lazerj7/MusicalDoorbell/Docs/PCB_3D_Back.png

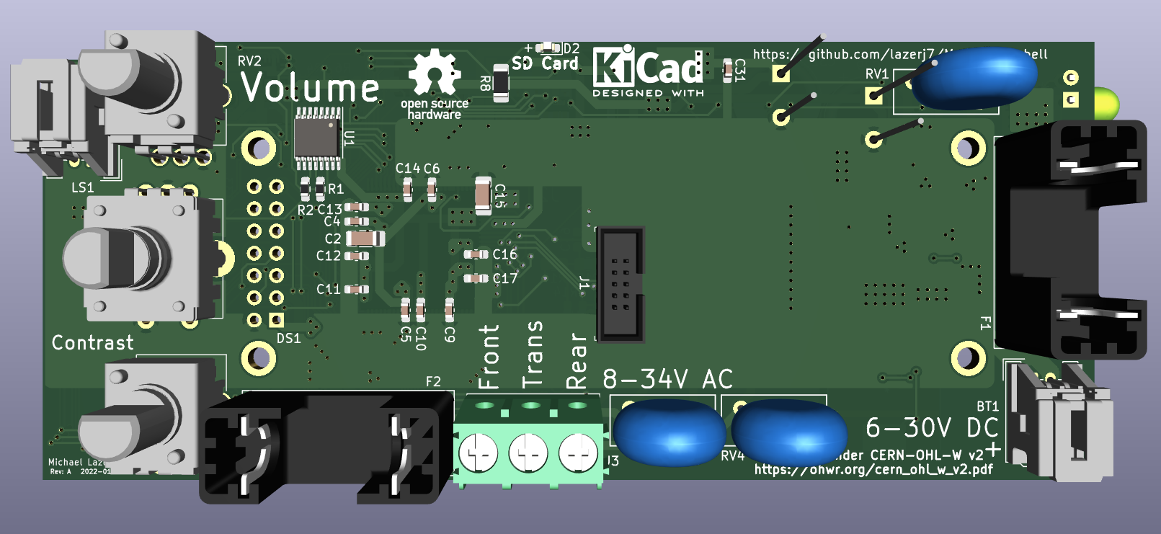
Docs/PCB_3D_Back.png
