lazerj7/MusicalDoorbell/Docs/PCB_3D_Front.png

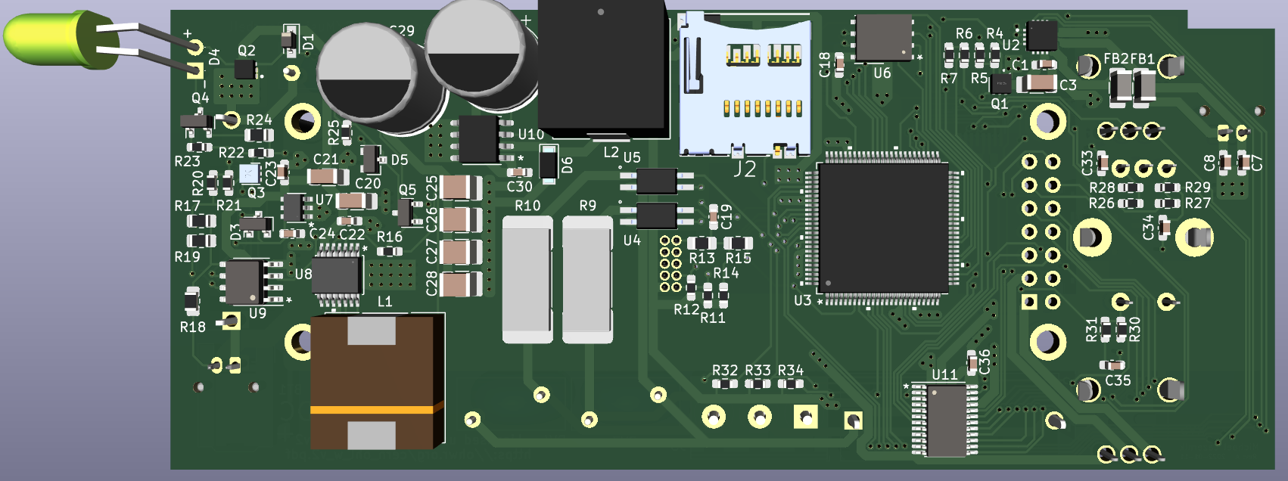
Docs/PCB_3D_Front.png
