lazerj7/MusicalDoorbell/Docs/Schematic.pdf

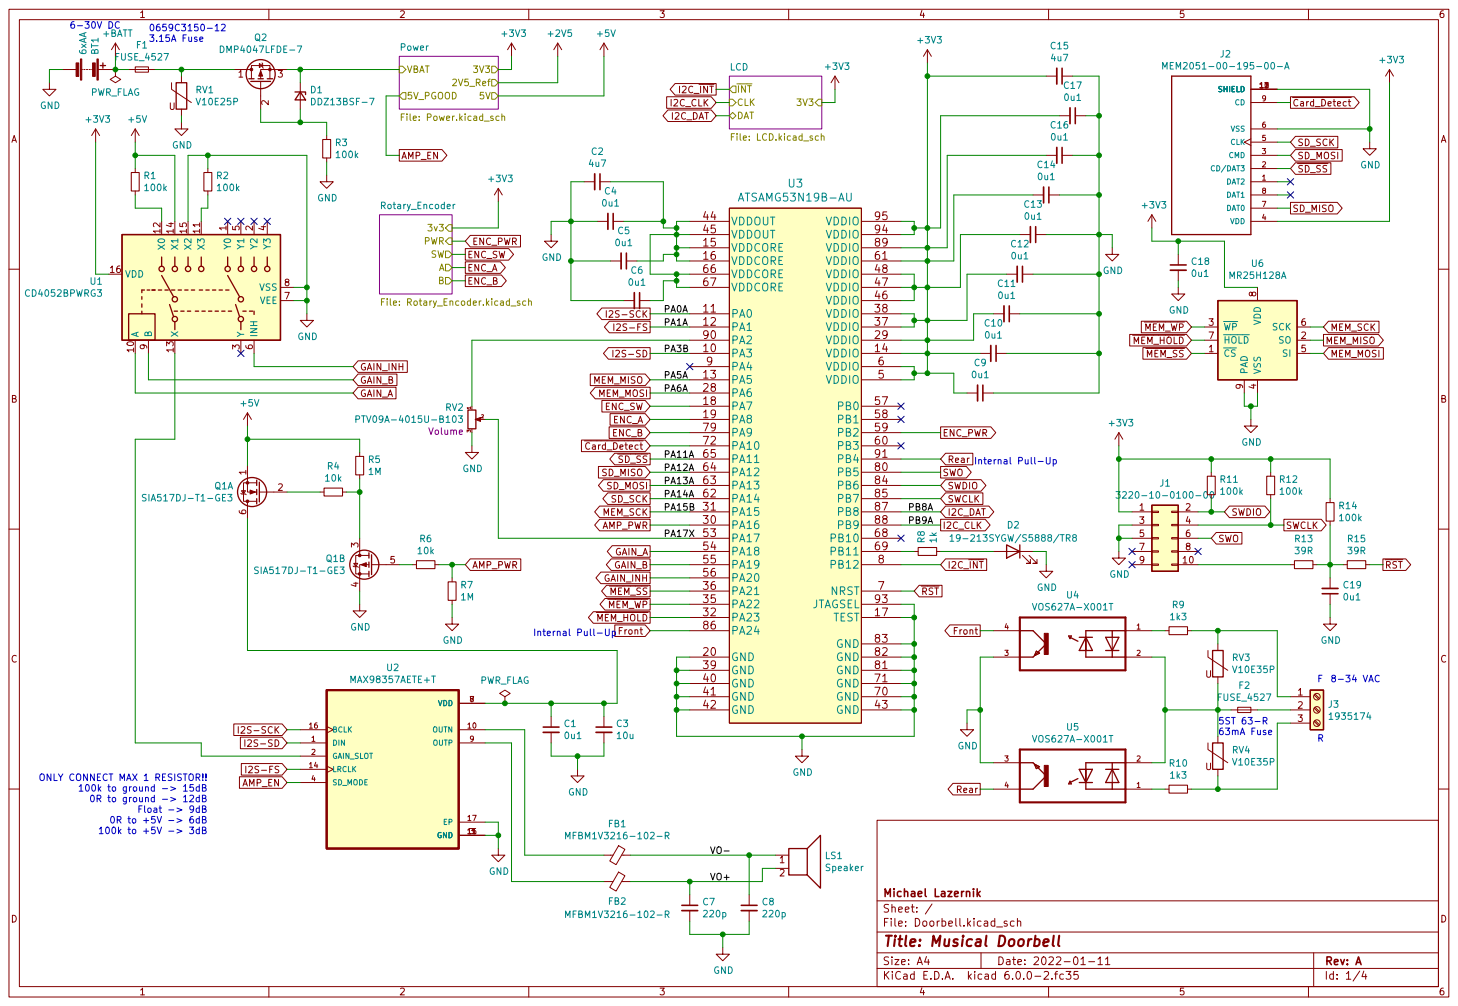
[picture p3: page 1]

4 SI 5 SCK 6 ~{HOLD} 7 VDD

63mA Fuse ONLY CONNECT MAX 1 RESISTOR!! 100k to ground -> 15dB

File: Doorbell.kicad_sch Sheet: / Michael Lazernik

Id: 1/4 Title: Musical Doorbell

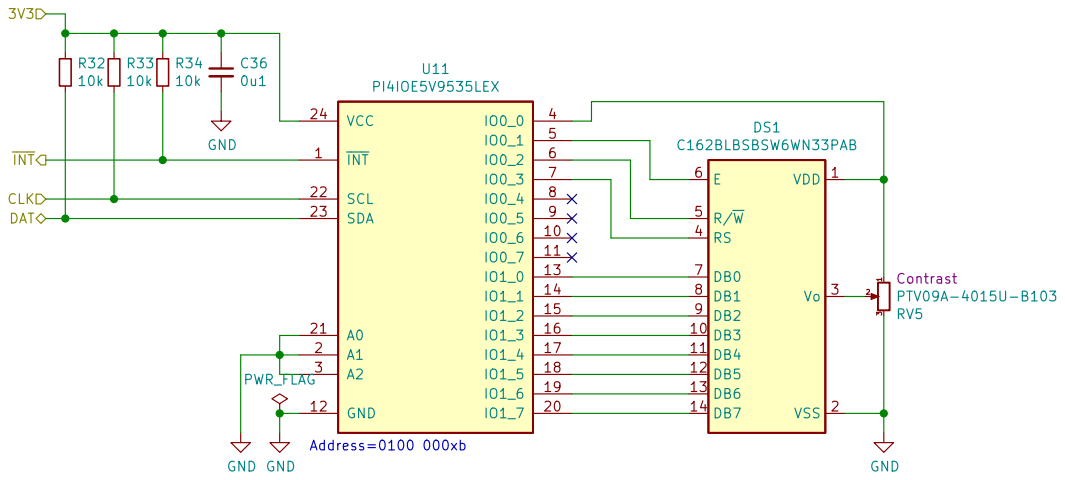
[picture p4: page 2]

3RV5PTV09A-4015U-B103 Contrast VDD 1 DB3 10 DB4 11 DB5 12 DB6 13 DB7 14 VSS 2 Vo 3 RS 4 R/~{W} 5 E

File: LCD.kicad_sch Sheet: /LCD/ Michael Lazernik

Id: 2/4 Title: Musical Doorbell

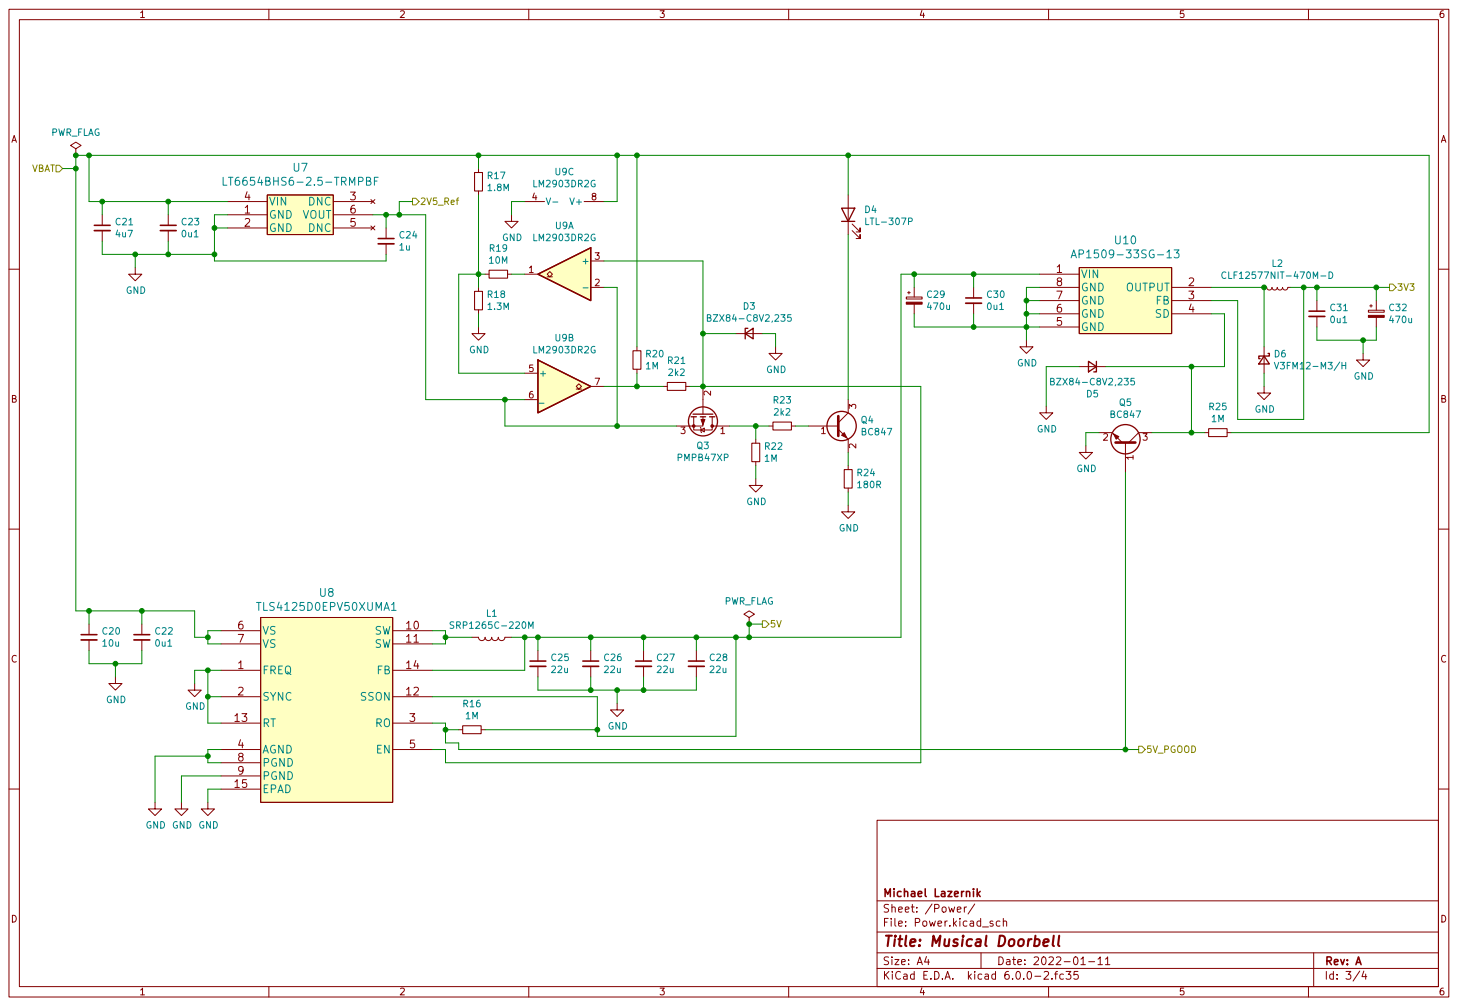
[picture p5: page 3]

GND GND

File: Power.kicad_sch Sheet: /Power/ Michael Lazernik

Id: 3/4 Title: Musical Doorbell

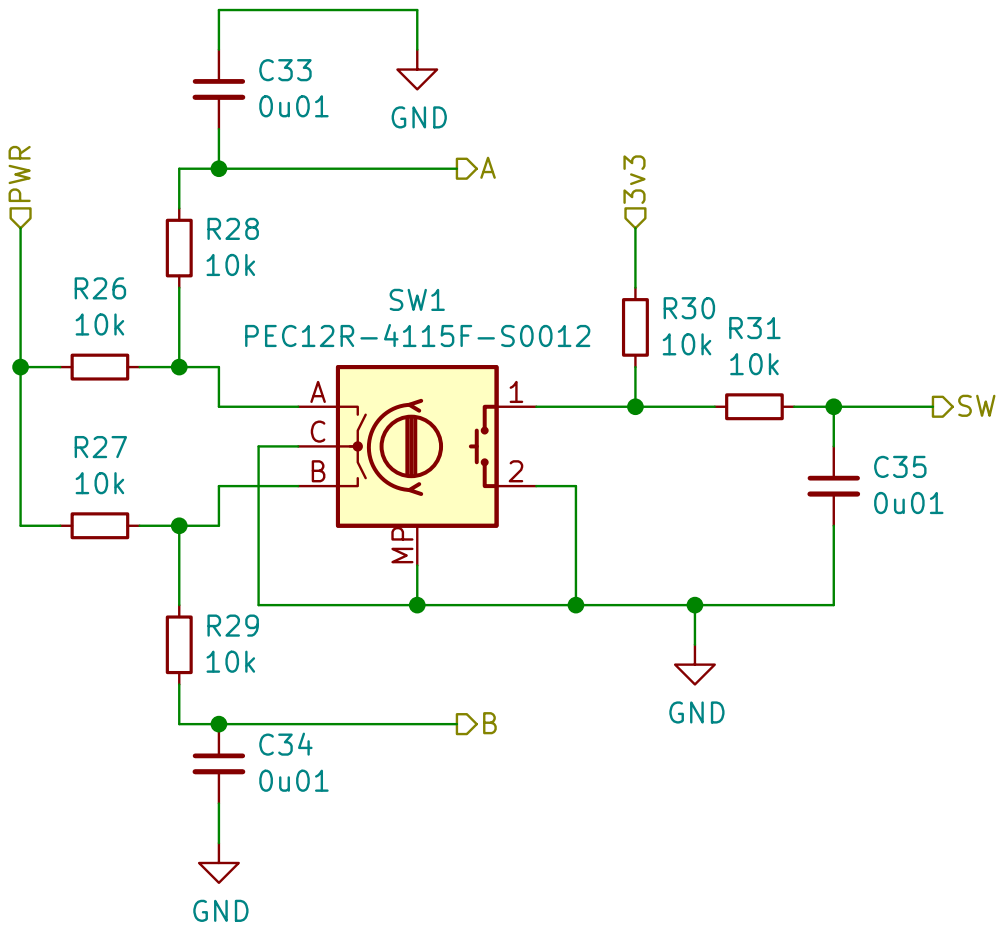
[picture p6: page 4]

File: Rotary_Encoder.kicad_sch
Id: 4/4 Title: Musical Doorbell
