lazerj7/MusicalDoorbell/Docs/PCB.pdf

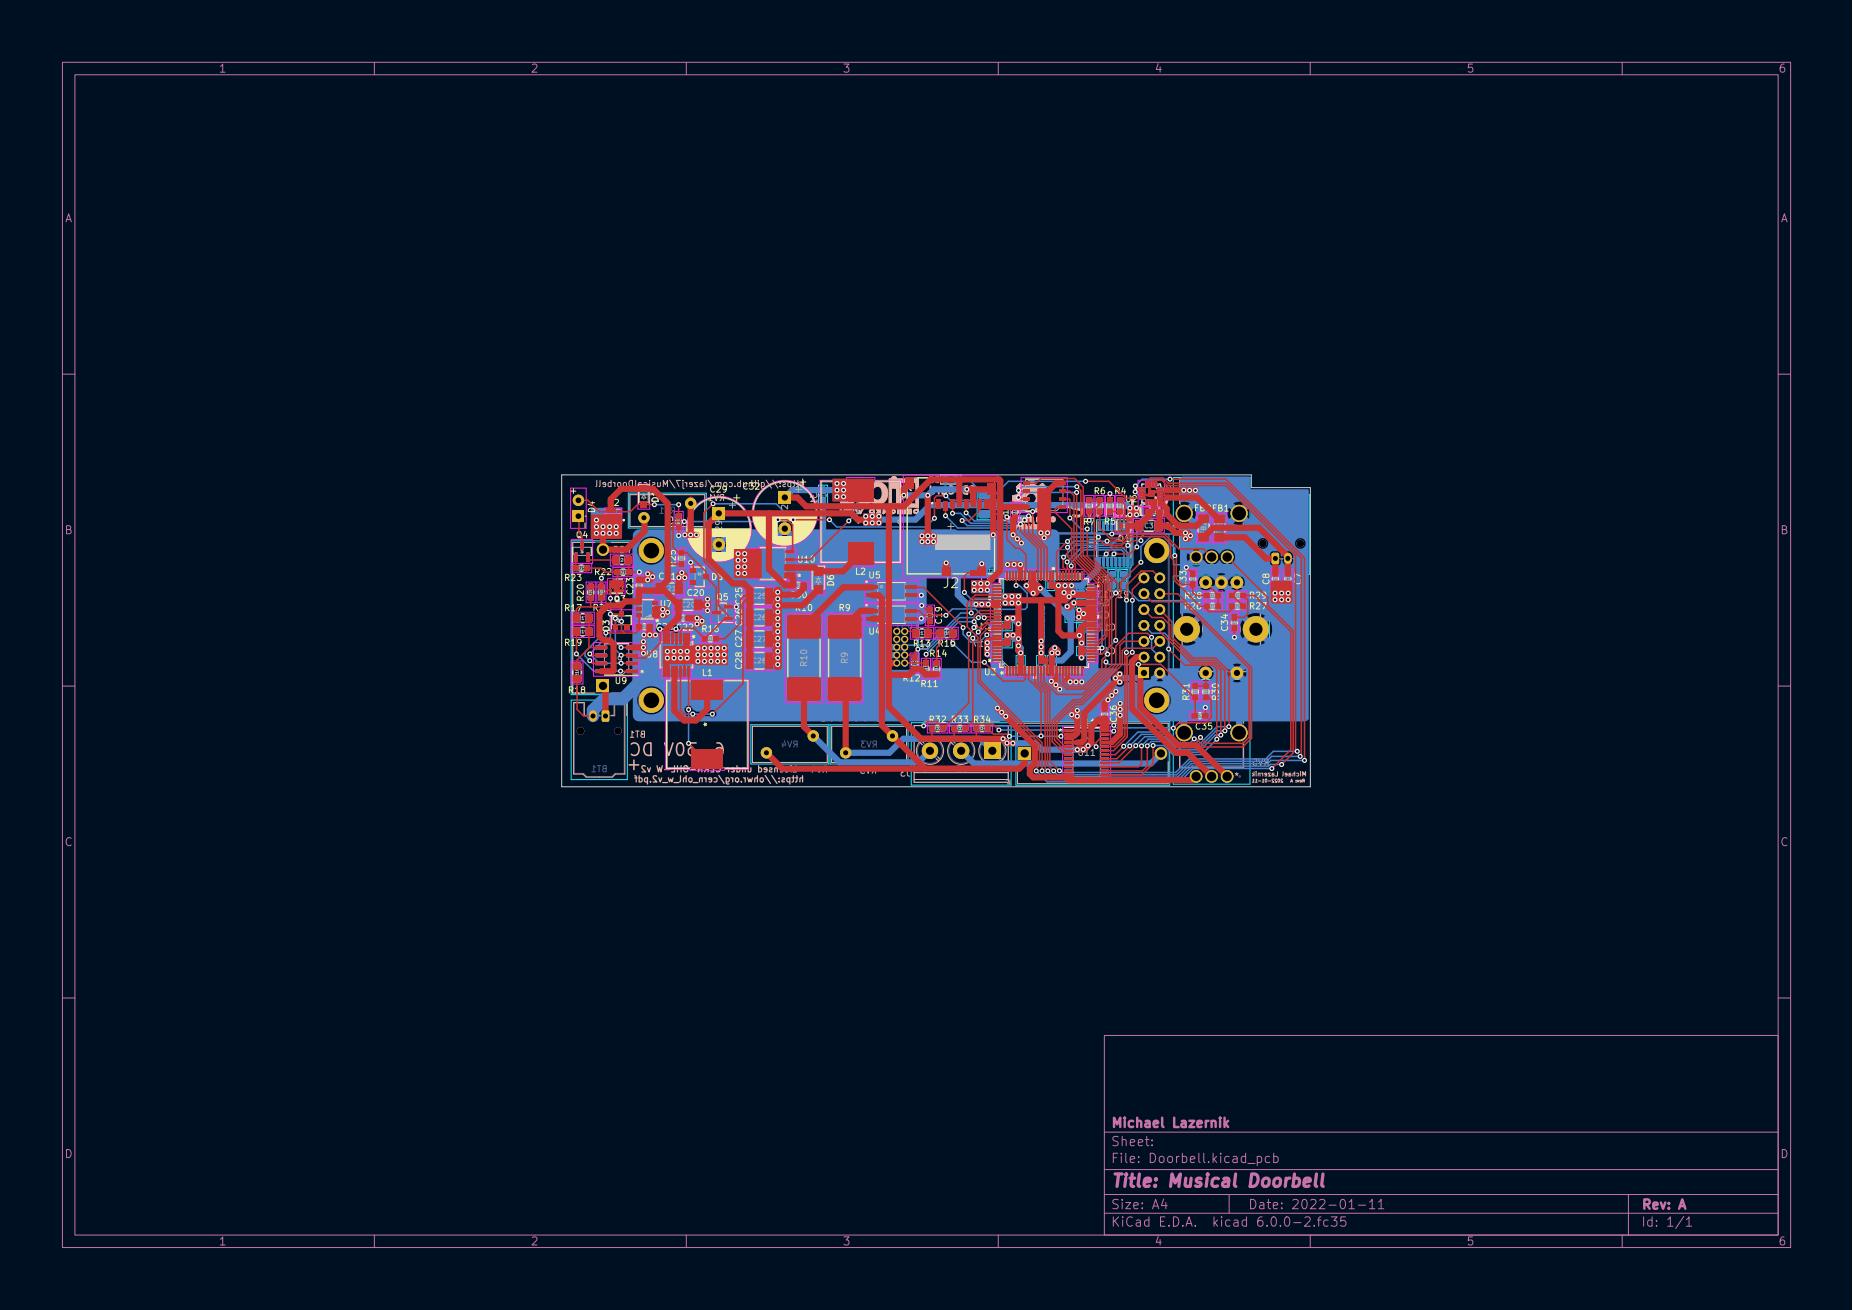
[picture p7: page 1]
