lazerj7/MusicalDoorbell/Docs/PCB_Back.pdf

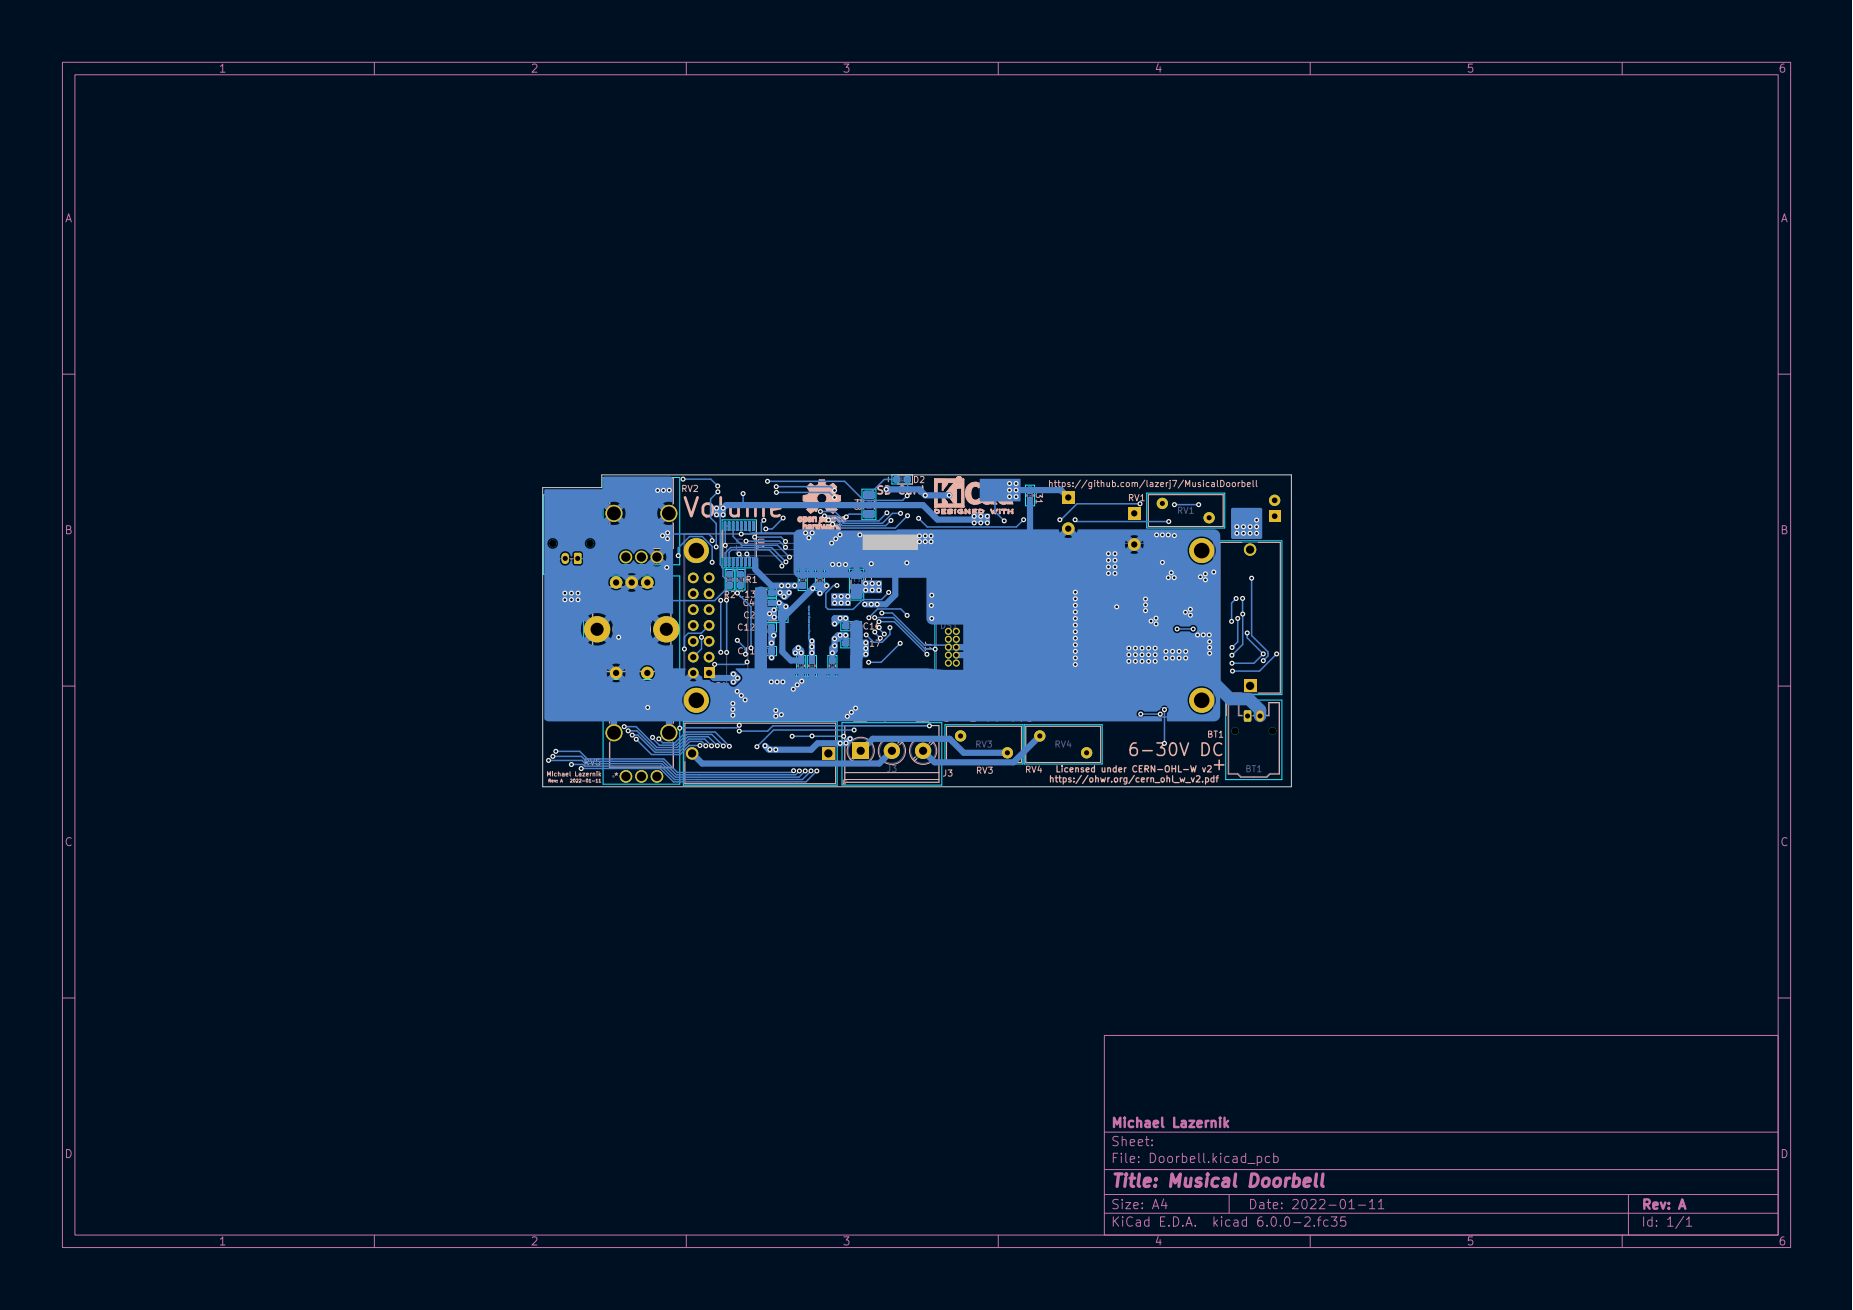
[picture p8: page 1]
