lazerj7/MusicalDoorbell/Docs/PCB_Front.pdf

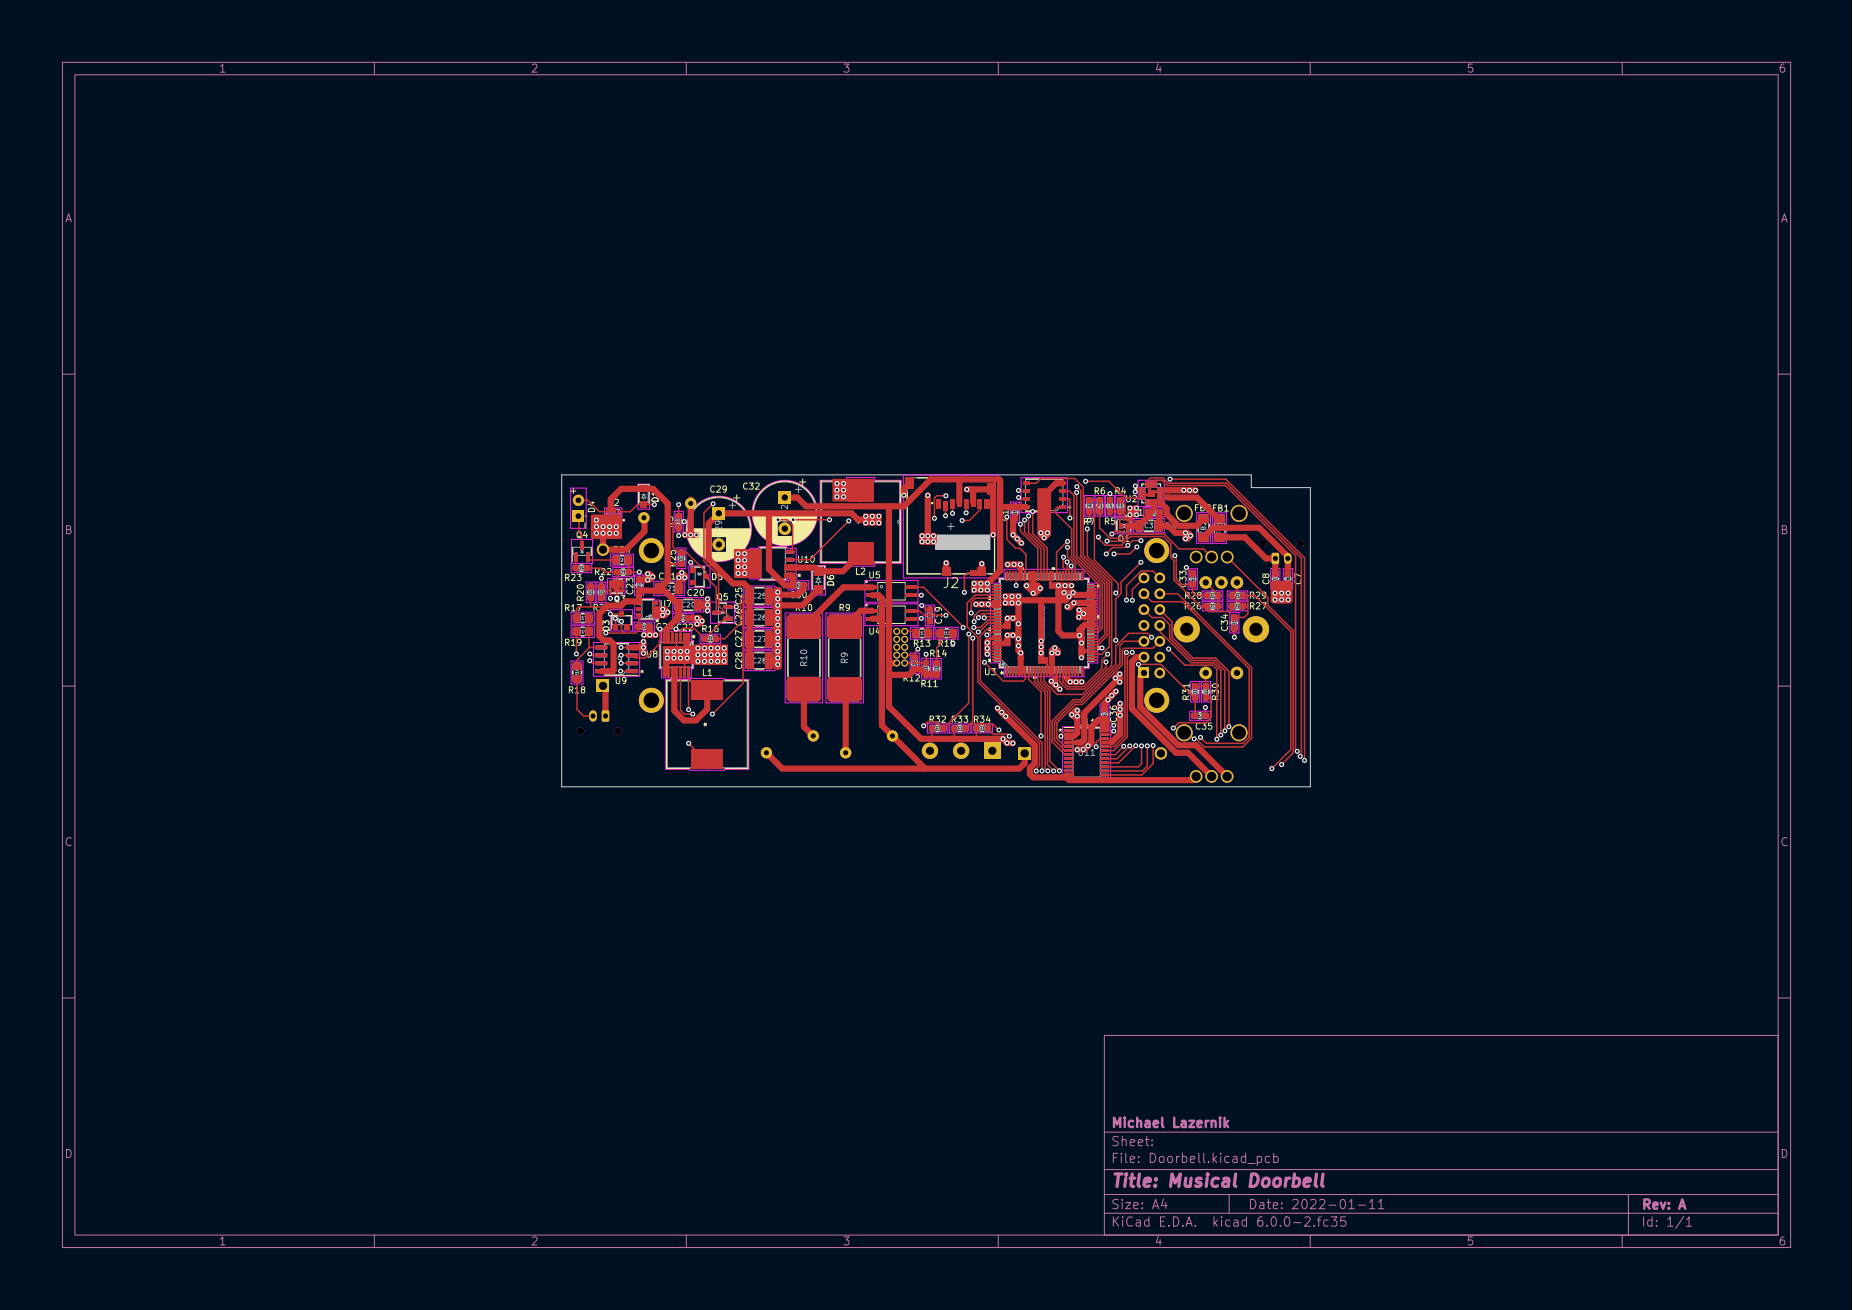
[picture p9: page 1]
