lazerj7/MusicalDoorbell/Hardware/Doorbell.kicad_pcb

## KiCad design Hardware/Doorbell.kicad_pcb (2022-02-26)

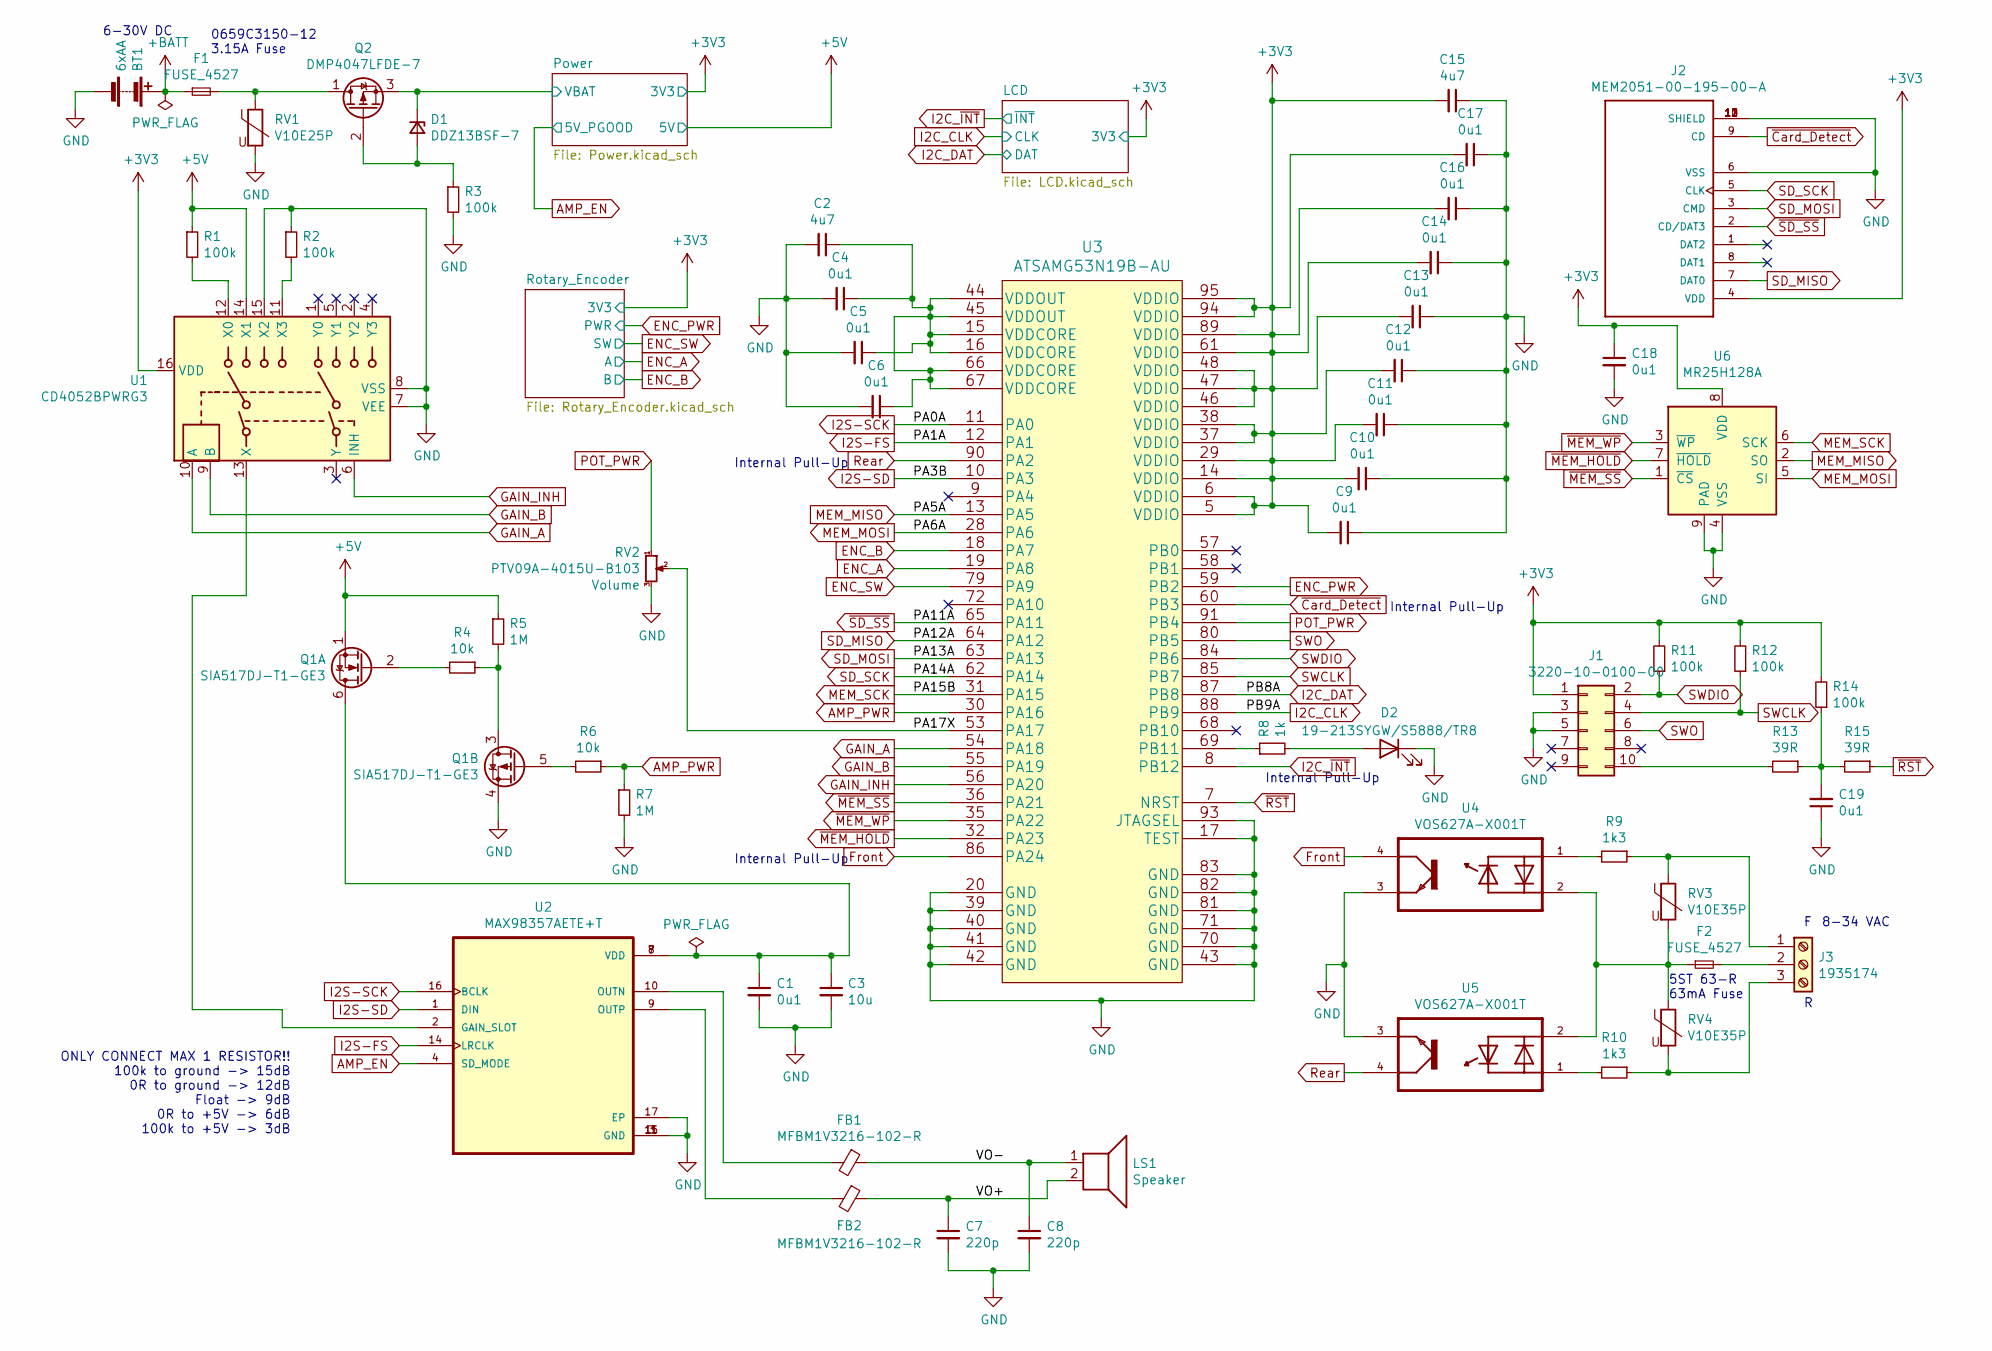
[picture p10: schematic Doorbell.kicad_sch, Musical Doorbell]

Parts:
BT1: 6xAA; Molex_MicroClasp_55935-0210_1x02_P2.00mm_Horizontal
C1, C4, C5, C6, C9, C10, C11, C12, C13, C14, C16, C17, C18, C19: 0u1; C_0603_1608Metric_Pad1.08x0.95mm_HandSolder
C2, C15: 4u7; C_1206_3216Metric_Pad1.33x1.80mm_HandSolder
C3: 10u; C_1206_3216Metric_Pad1.33x1.80mm_HandSolder
C7, C8: 220p; C_0603_1608Metric_Pad1.08x0.95mm_HandSolder
D1: DDZ13BSF-7; D_SOD-323_HandSoldering
D2: 19-213SYGW/S5888/TR8; LED_0603_1608Metric_Pad1.05x0.95mm_HandSolder
F1, F2: FUSE_4527
FB1, FB2: MFBM1V3216-102-R; L_1206_3216Metric_Pad1.42x1.75mm_HandSolder
J1: 3220-10-0100-00
J2: MEM2051-00-195-00-A
J3: 1935174; TerminalBlock_Phoenix_PT-1,5-3-5.0-H_1x03_P5.00mm_Horizontal
LS1: Speaker; Molex_MicroClasp_55935-0210_1x02_P2.00mm_Horizontal
Q1: SIA517DJ-T1-GE3; Vishay_PowerPAK_SC70-6L_Dual
Q2: DMP4047LFDE-7
R1, R2, R3, R11, R12, R14: 100k; R_0603_1608Metric_Pad0.98x0.95mm_HandSolder
R4, R6: 10k; R_0603_1608Metric_Pad0.98x0.95mm_HandSolder
R5, R7: 1M; R_0603_1608Metric_Pad0.98x0.95mm_HandSolder
R8: 1k; R_1206_3216Metric_Pad1.30x1.75mm_HandSolder
R9, R10: 1k3; 35501K3FT
R13, R15: 39R; R_0805_2012Metric_Pad1.20x1.40mm_HandSolder
RV1: V10E25P; RV_Disc_D12mm_W5.1mm_P7.5mm
RV2: PTV09A-4015U-B103
RV3, RV4: V10E35P; RV_Disc_D12mm_W5.8mm_P7.5mm
U1: CD4052BPWRG3; TSSOP-16_4.4x5mm_P0.65mm
U2: MAX98357AETE+T; MAX98357AETE_T
U3: ATSAMG53N19B-AU
U4, U5: VOS627A-X001T
U6: MR25H128A; DFN-8-1EP_6x5mm_P1.27mm_EP2x2mm

Connections:
+3V3: C9.2, C10.2, C11.2, C12.2, C13.2, C14.2, C15.2, C16.2, C17.2, C18.1, J1.1, J2.4 (VDD), R11.2, R12.2, R14.2, U1.16 (VDD), U3.5 (VDDIO), U3.6 (VDDIO), U3.14 (VDDIO), U3.29 (VDDIO), U3.37 (VDDIO), U3.38 (VDDIO), U3.46 (VDDIO), U3.47 (VDDIO), U3.48 (VDDIO), U3.61 (VDDIO), U3.89 (VDDIO), U3.94 (VDDIO), U3.95 (VDDIO), U6.8 (VDD); also elsewhere on the board
+5V: Q1.1 (S2), R1.1, R5.1, U1.14 (X1); also elsewhere on the board
+BATT: BT1.1 (+), F1.1
/PA17X: RV2.2, U3.53 (PA17)
/Power/VBAT: D1.1 (K), Q2.3 (S); also elsewhere on the board
/VO+: C7.1, FB2.1, LS1.2
/VO-: C8.1, FB1.1, LS1.1
AMP_EN: U2.4 (SD_MODE); also elsewhere on the board
AMP_PWR: R6.1, R7.1, U3.30 (PA16)
ENC_A: U3.19 (PA8); also elsewhere on the board
ENC_B: U3.18 (PA7); also elsewhere on the board
ENC_PWR: U3.59 (PB2); also elsewhere on the board
ENC_SW: U3.79 (PA9); also elsewhere on the board
Front: U3.86 (PA24), U4.4
GAIN_A: U1.10 (A), U3.54 (PA18)
GAIN_B: U1.9 (B), U3.55 (PA19)
GAIN_INH: U1.6 (INH), U3.56 (PA20)
GND: BT1.2 (-), C1.2, C2.2, C3.2, C4.2, C5.2, C6.2, C7.2, C8.2, C9.1, C10.1, C11.1, C12.1, C13.1, C14.1, C15.1, C16.1, C17.1, C18.2, C19.1, D2.1 (K), J1.3, J1.5, J2.6 (VSS), J2.10 (SHIELD), J2.11 (SHIELD), J2.12 (SHIELD), J2.13 (SHIELD), Q1.4 (S2), R2.1, R3.2, R7.2, RV1.2, RV2.3, RV2.4, RV2.5, U1.7 (VEE), U1.8 (VSS), U1.15 (X2), U2.3 (GND), U2.11 (GND), U2.15 (GND), U2.17 (EP), U3.17 (TEST), U3.20 (GND), U3.39 (GND), U3.40 (GND), U3.41 (GND), U3.42 (GND), U3.43 (GND), U3.70 (GND), U3.71 (GND), U3.81 (GND), U3.82 (GND), U3.83 (GND), U3.93 (JTAGSEL), U4.3, U5.3, U6.4 (VSS), U6.9 (PAD); also elsewhere on the board
I2C_CLK: U3.88 (PB9); also elsewhere on the board
I2C_DAT: U3.87 (PB8); also elsewhere on the board
I2C_~INT: U3.8 (PB12); also elsewhere on the board
I2S-FS: U2.14 (LRCLK), U3.12 (PA1)
I2S-SCK: U2.16 (BCLK), U3.11 (PA0)
I2S-SD: U2.1 (DIN), U3.10 (PA3)
MEM_MISO: U3.13 (PA5), U6.2 (SO)
MEM_MOSI: U3.28 (PA6), U6.5 (SI)
MEM_SCK: U3.31 (PA15), U6.6 (SCK)
unnamed: C1.1, C3.1, Q1.6 (D2), U2.7 (VDD), U2.8 (VDD)
unnamed: C2.1, C4.1, C5.1, C6.1, U3.15 (VDDCORE), U3.16 (VDDCORE), U3.44 (VDDOUT), U3.45 (VDDOUT), U3.66 (VDDCORE), U3.67 (VDDCORE)
unnamed: C19.2, R13.1, R14.1, R15.2
unnamed: D1.2 (A), Q2.2 (G), R3.1
unnamed: D2.2 (A), R8.2
unnamed: F1.2, Q2.1 (D), RV1.1
unnamed: F2.1, RV3.2, RV4.1, U4.2, U5.2
unnamed: F2.2, J3.2
unnamed: FB1.2, U2.10 (OUTN)
unnamed: FB2.2, U2.9 (OUTP)
unnamed: J1.10, R13.2
unnamed: J3.1, R9.1, RV3.1
unnamed: J3.3, R10.1, RV4.2
unnamed: Q1.2 (G2), R4.2
unnamed: Q1.3 (D2), R4.1, R5.2
unnamed: Q1.5 (G2), R6.2
unnamed: R1.2, U1.12 (X0)
unnamed: R2.2, U1.11 (X3)
unnamed: R8.1, U3.69 (PB11)
unnamed: R9.2, U4.1
unnamed: R10.2, U5.1
unnamed: U1.13 (X), U2.2 (GAIN_SLOT)
POT_PWR: RV2.1, U3.91 (PB4)
Rear: U3.90 (PA2), U5.4
SD_MISO: J2.7 (DAT0), U3.64 (PA12)
SD_MOSI: J2.3 (CMD), U3.63 (PA13)
SD_SCK: J2.5 (CLK), U3.62 (PA14)
SWCLK: J1.4, R12.1, U3.85 (PB7)
SWDIO: J1.2, R11.1, U3.84 (PB6)
SWO: J1.6, U3.80 (PB5)
~Card_Detect: J2.9 (CD), U3.60 (PB3)
~MEM_HOLD: U3.32 (PA23), U6.7 (~HOLD)
~MEM_SS: U3.36 (PA21), U6.1 (~CS)
~MEM_WP: U3.35 (PA22), U6.3 (~WP)
~RST: R15.1, U3.7 (NRST)
~SD_SS: J2.2 (CD/DAT3), U3.65 (PA11)

Notes on the sheet:
Internal Pull-Up
6-30V DC
8-34 VAC
0659C3150-12 3.15A Fuse
ONLY CONNECT MAX 1 RESISTOR!! 100k to ground -> 15dB 0R to ground -> 12dB Float -> 9dB 0R to +5V -> 6dB 100k to +5V -> 3dB
5ST 63-R 63mA Fuse

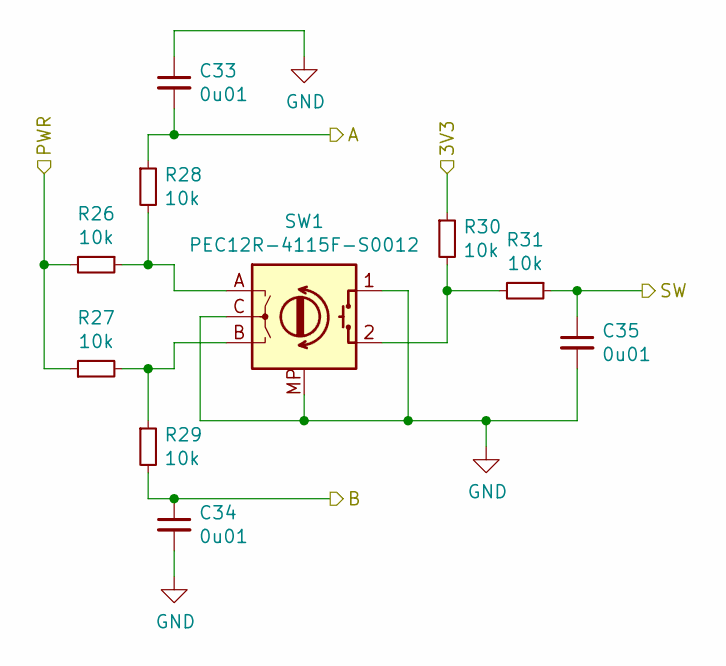
[picture p11: schematic Rotary_Encoder.kicad_sch, Musical Doorbell]

Parts:
C33, C34, C35: 0u01; C_0603_1608Metric_Pad1.08x0.95mm_HandSolder
R26, R27, R28, R29, R30, R31: 10k; R_0603_1608Metric_Pad0.98x0.95mm_HandSolder
SW1: PEC12R-4115F-S0012

Connections:
+3V3: R30.1; also elsewhere on the board
ENC_A: C33.2, R28.1; also elsewhere on the board
ENC_B: C34.1, R29.2; also elsewhere on the board
ENC_PWR: R26.2, R27.1; also elsewhere on the board
ENC_SW: C35.1, R31.1; also elsewhere on the board
GND: C33.1, C34.2, C35.2, SW1.1, SW1.C, SW1.MP; also elsewhere on the board
unnamed: R26.1, R28.2, SW1.A
unnamed: R27.2, R29.1, SW1.B
unnamed: R30.2, R31.2, SW1.2

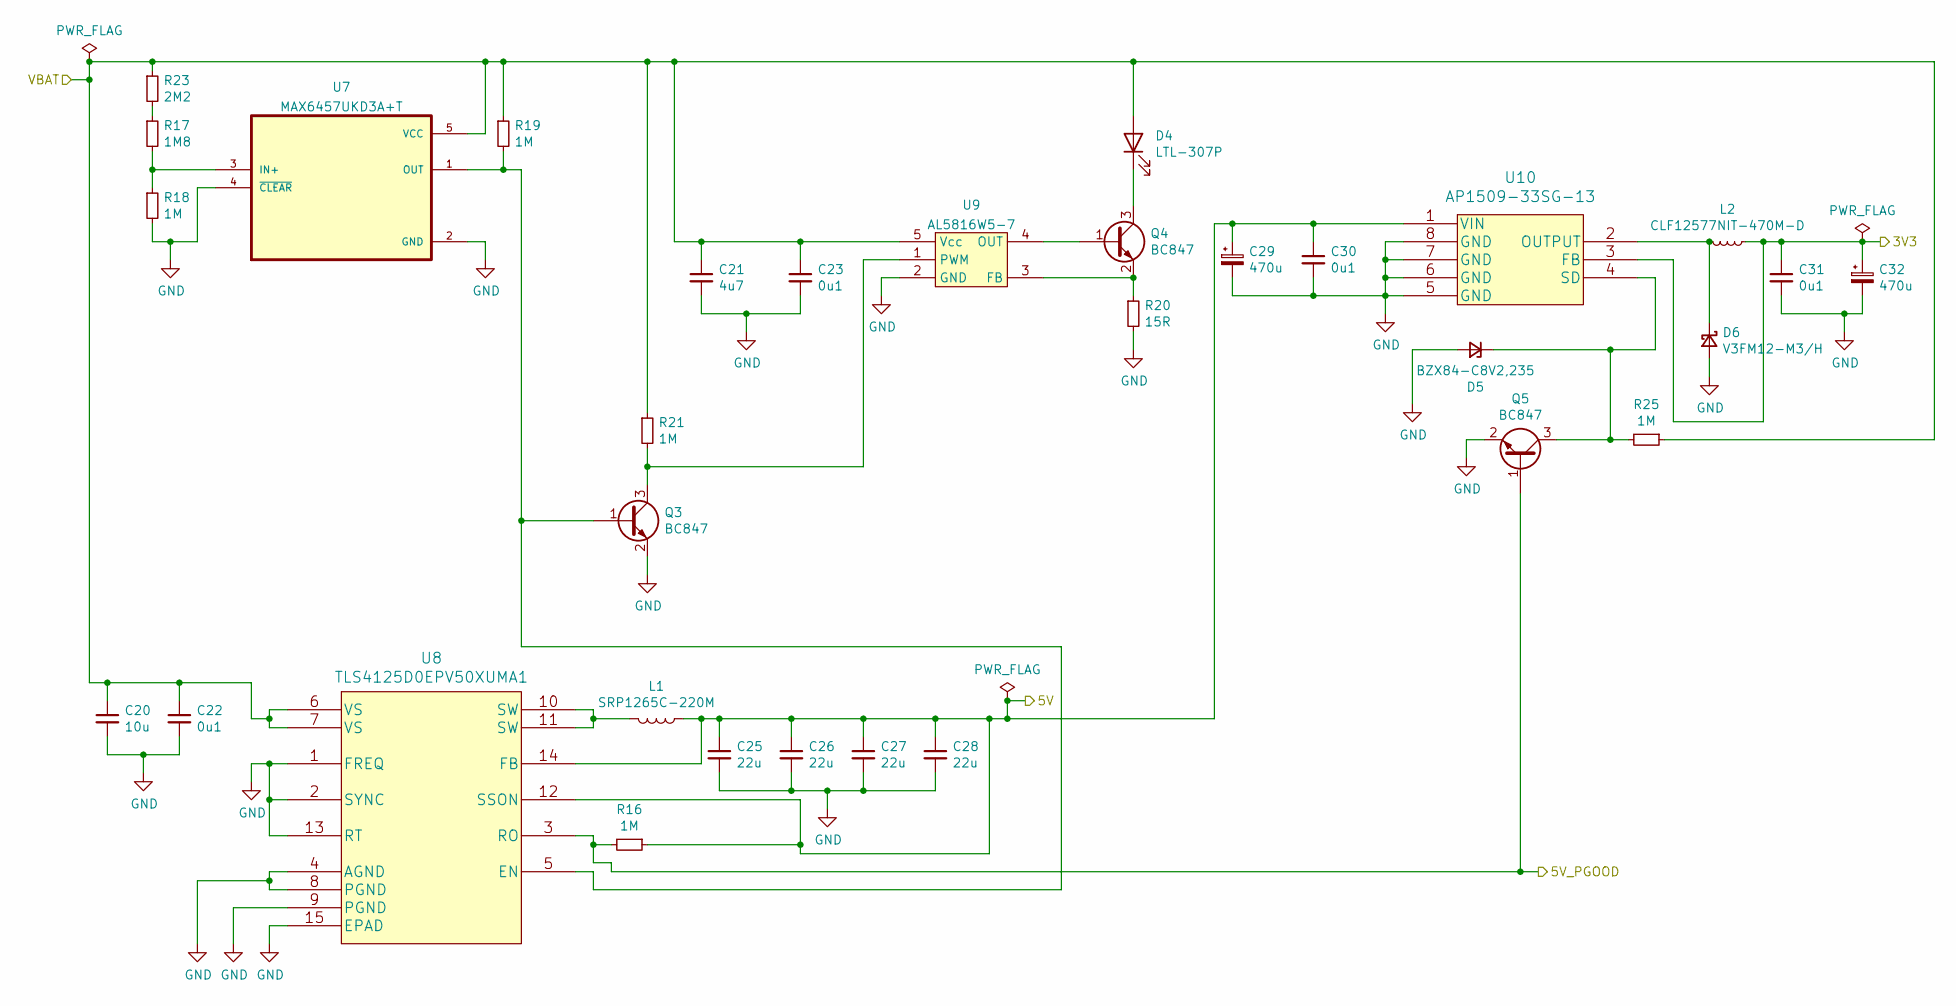
[picture p12: schematic Power.kicad_sch, Musical Doorbell]

Parts:
C20: 10u; C_1206_3216Metric_Pad1.33x1.80mm_HandSolder
C21: 4u7; C_1206_3216Metric_Pad1.33x1.80mm_HandSolder
C22, C23, C30, C31: 0u1; C_0603_1608Metric_Pad1.08x0.95mm_HandSolder
C25, C26, C27, C28: 22u; C_1210_3225Metric_Pad1.33x2.70mm_HandSolder
C29, C32: 470u; EEH-AZK1E471B
D4: LTL-307P
D5: BZX84-C8V2,235; D_SOT-23_ANK
D6: V3FM12-M3/H; V3FM12-M3_H
L1: SRP1265C-220M
L2: CLF12577NIT-470M-D
Q3, Q4, Q5: BC847; SOT-23
R16, R18, R19, R21, R25: 1M; R_0603_1608Metric_Pad0.98x0.95mm_HandSolder
R17: 1M8; R_0805_2012Metric_Pad1.20x1.40mm_HandSolder
R20: 15R; R_0805_2012Metric_Pad1.20x1.40mm_HandSolder
R23: 2M2; R_0603_1608Metric_Pad0.98x0.95mm_HandSolder
U7: MAX6457UKD3A+T
U8: TLS4125D0EPV50XUMA1
U9: AL5816W5-7
U10: AP1509-33SG-13

Connections:
+3V3: C31.1, C32.1, L2.1, U10.3 (FB); also elsewhere on the board
+5V: C25.1, C26.1, C27.1, C28.1, C29.1, C30.1, L1.1, R16.1, U8.12 (SSON), U8.14 (FB), U10.1 (VIN); also elsewhere on the board
/Power/VBAT: C20.1, C21.1, C22.1, C23.1, D4.2 (A), R19.1, R21.1, R23.1, R25.1, U7.5 (VCC), U8.6 (VS), U8.7 (VS), U9.5 (Vcc); also elsewhere on the board
AMP_EN: Q5.1 (B), R16.2, U8.3 (RO); also elsewhere on the board
GND: C20.2, C21.2, C22.2, C23.2, C25.2, C26.2, C27.2, C28.2, C29.2, C30.2, C31.2, C32.2, D5.2 (A), D6.2 (A), Q3.2 (E), Q5.2 (E), R18.2, R20.2, U7.2 (GND), U7.4 (~CLEAR), U8.1 (FREQ), U8.2 (SYNC), U8.4 (AGND), U8.8 (PGND), U8.9 (PGND), U8.13 (RT), U8.15 (EPAD), U9.2 (GND), U10.5 (GND), U10.6 (GND), U10.7 (GND), U10.8 (GND); also elsewhere on the board
unnamed: D4.1 (K), Q4.3 (C)
unnamed: D5.1 (K), Q5.3 (C), R25.2, U10.4 (SD)
unnamed: D6.1 (K), L2.2, U10.2 (OUTPUT)
unnamed: L1.2, U8.10 (SW), U8.11 (SW)
unnamed: Q3.1 (B), R19.2, U7.1 (OUT), U8.5 (EN)
unnamed: Q3.3 (C), R21.2, U9.1 (PWM)
unnamed: Q4.1 (B), U9.4 (OUT)
unnamed: Q4.2 (E), R20.1, U9.3 (FB)
unnamed: R17.1, R23.2
unnamed: R17.2, R18.1, U7.3 (IN+)

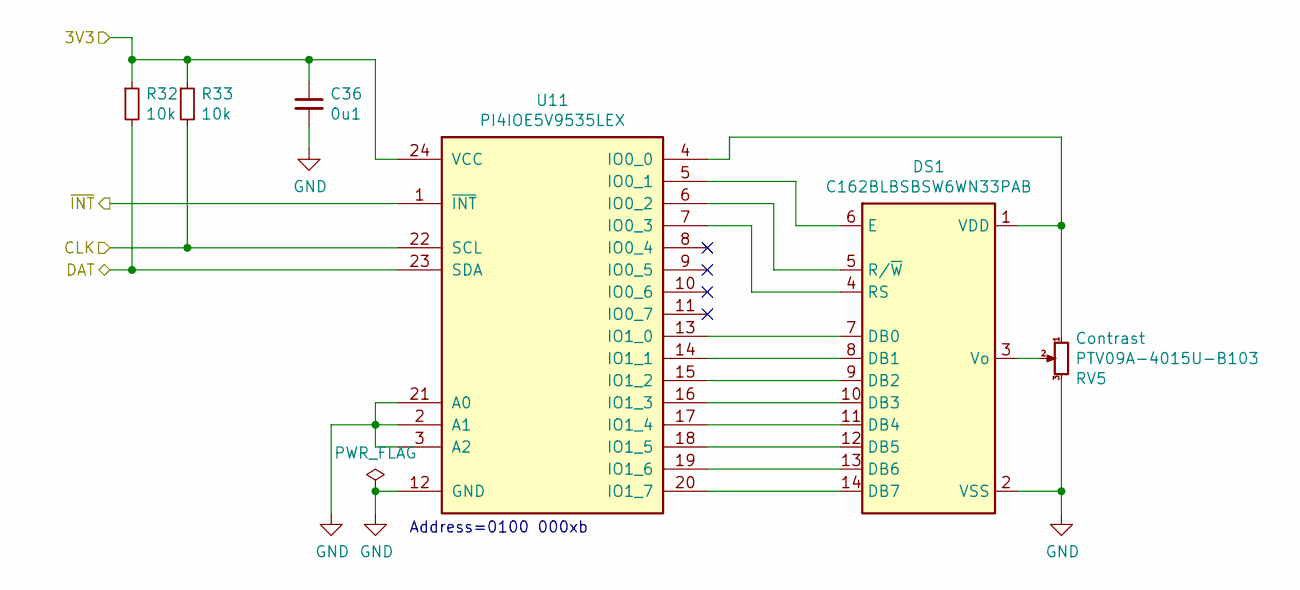
[picture p13: schematic LCD.kicad_sch, Musical Doorbell]

Parts:
C36: 0u1; C_0603_1608Metric_Pad1.08x0.95mm_HandSolder
DS1: C162BLBSBSW6WN33PAB
R32, R33: 10k; R_0603_1608Metric_Pad0.98x0.95mm_HandSolder
RV5: PTV09A-4015U-B103
U11: PI4IOE5V9535LEX; TSSOP-24_4.4x7.8mm_P0.65mm

Connections:
+3V3: C36.1, R32.1, R33.1, U11.24 (VCC); also elsewhere on the board
GND: C36.2, DS1.2 (VSS), RV5.3, RV5.4, RV5.5, U11.2 (A1), U11.3 (A2), U11.12 (GND), U11.21 (A0); also elsewhere on the board
I2C_CLK: R33.2, U11.22 (SCL); also elsewhere on the board
I2C_DAT: R32.2, U11.23 (SDA); also elsewhere on the board
I2C_~INT: U11.1 (~INT); also elsewhere on the board
unnamed: DS1.1 (VDD), RV5.1, U11.4 (IO0_0)
unnamed: DS1.3 (Vo), RV5.2
unnamed: DS1.4 (RS), U11.7 (IO0_3)
unnamed: DS1.5 (R/~W), U11.6 (IO0_2)
unnamed: DS1.6 (E), U11.5 (IO0_1)
unnamed: DS1.7 (DB0), U11.13 (IO1_0)
unnamed: DS1.8 (DB1), U11.14 (IO1_1)
unnamed: DS1.9 (DB2), U11.15 (IO1_2)
unnamed: DS1.10 (DB3), U11.16 (IO1_3)
unnamed: DS1.11 (DB4), U11.17 (IO1_4)
unnamed: DS1.12 (DB5), U11.18 (IO1_5)
unnamed: DS1.13 (DB6), U11.19 (IO1_6)
unnamed: DS1.14 (DB7), U11.20 (IO1_7)

Notes on the sheet:
Address=0100 000xb

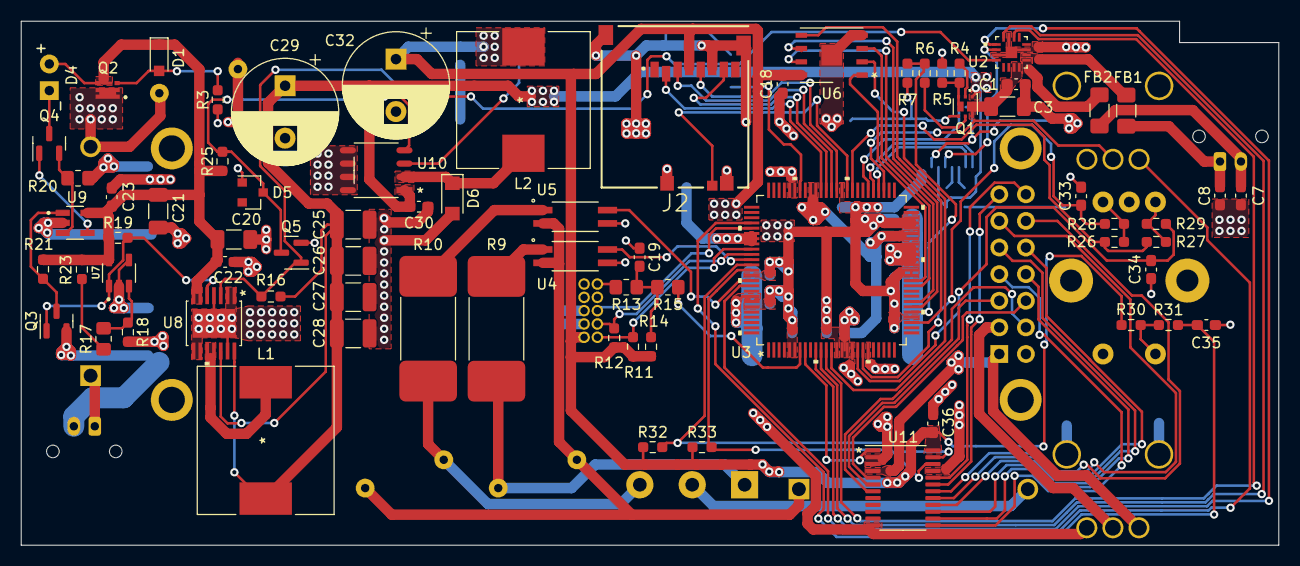
[picture p14: board Doorbell.kicad_pcb from above]

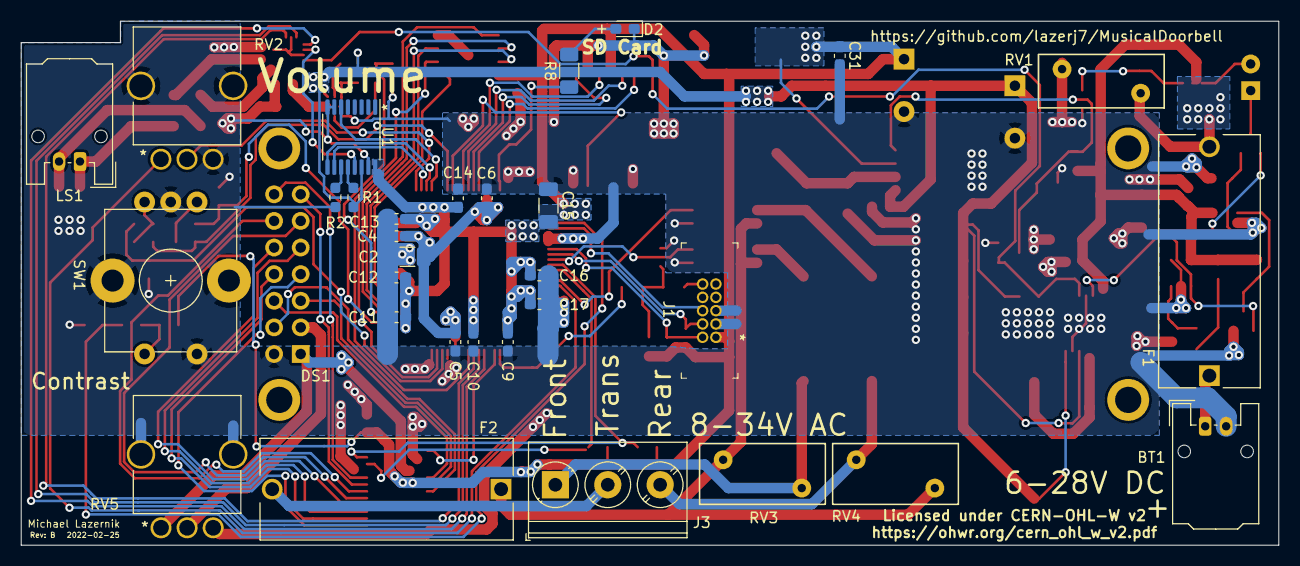
[picture p15: board Doorbell.kicad_pcb from below]

Board: 2 copper layers, 120.0 x 50.0 mm, 105 parts (32 on the bottom side), 89 nets.
