lazerj7/MusicalDoorbell/(commit log)

2022-01-10 Clean up custom KiCad libraries
    - Clean up the directory structure for KiCad custom libraries.
    - Fix paths in KiCad schematic and pcb for symbols, footprints, and
    3d models for custom libraries.
    [Doorbell.kicad_pcb, Doorbell.kicad_sch, LCD.kicad_sch, Power.kicad_sch, Rotary_Encoder.kicad_sch]
2022-01-10 Cleanup custom KiCad libraries
    - Delete unneeded/unused files
    - Cleanup symbol library files for custom libraries
    [Doorbell.kicad_sch, LCD.kicad_sch, Power.kicad_sch, Rotary_Encoder.kicad_sch]
2022-01-11 Switch to local libraries for KiCad schematic
    - Move all KiCad schematic symbols into local libraries
    - Fix KiCad schematic library links to point to local libraries
    [Doorbell.kicad_pcb, Doorbell.kicad_sch, LCD.kicad_sch, Power.kicad_sch, Rotary_Encoder.kicad_sch]
2022-01-11 Move KiCad global footprint and 3d models to local
    - Move KiCad global footprint and 3d models to local directories
    - Reassign footprints in KiCad schematic/PCB from global libraries to
    local libraries
    - Reassign global 3d models to local 3d models for KiCad
    - Update KiCad PCB with all local footprints
    [Doorbell.kicad_pcb, Doorbell.kicad_sch, LCD.kicad_sch, Power.kicad_sch]
2022-01-11 Cleanup silkscreen
    - Make sure component IDs are visible and clear
    - Make sure pin 1 of IC's has marker
    - Overall housekeeping of silkscreen layer
    [Doorbell.kicad_pcb]
2022-01-13 Add some initial documentation and production files
    - Add BOM to Docs in ods, pdf, and md formats
    - Add Schematic to Docs in pdf format
    - Add PCB layouts to Docs in pdf format
    - Add 3D PCB images to Docs in png format
    - Add 3D PCB VRML/wrl file to Docs
    - Add component 3D models in step format to local libs in Hardware
    (needed to make KiCadStepUp happy)
    - Add 3D PCB model to docs in step and fcstd formats
    - Add gerbers and drill files to Production
    - Add zip archive containing gerbers and drill files to Production
    [BOM.ods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]
2022-01-13 Fix some minor formatting issues in BOM
    -Fix column heights in BOM.ods
    -Regenerate BOM.pdf from BOM.ods
    [BOM.ods]
2022-02-26 Bump to board revision B
    - Redesign low battery circuit
    - Replace comparator with PMIC
    - Utilize LED Driver IC
    - Remove unneeded 2.5v voltage reference
    - Reroute some signals onto wkup/external interrupt pins
    [Doorbell-B_Cu.gbl, Doorbell-B_Mask.gbs, Doorbell-B_Paste.gbp, Doorbell-B_Silkscreen.gbo, Doorbell-Edge_Cuts.gm1, Doorbell-F_Cu.gtl, Doorbell-F_Mask.gts, Doorbell-F_Paste.gtp]
