lazerj7/MusicalDoorbell/(notices)

Notices in the files:
Hardware/Doorbell.kicad_pcb:
Licensed under CERN-OHL-W v2
parts and their libraries:
Copyright 2021 Accelerated Designs. All rights reserved.
